plan44/p44ayabd/ayab_firmware/serial-protocol-docs/Communication Specification — AYABInterface 0.0.9 (AYAB serial protocol v4).pdf

Docs (http://ayabinterface.readthedocs.io/en/latest/index.html) » Communica-on Specifica-on

# Communication Specification

This document specifies the communica-on between the host and a controller with the AYAB firmware. (https://github.com/AllYarnsAreBeautiful/ayab-firmware)

## Serial Communication

115200 baud

Line Ending: | \n\r | (10 13) Each message ends with a Line Ending.

## Sequence Chart

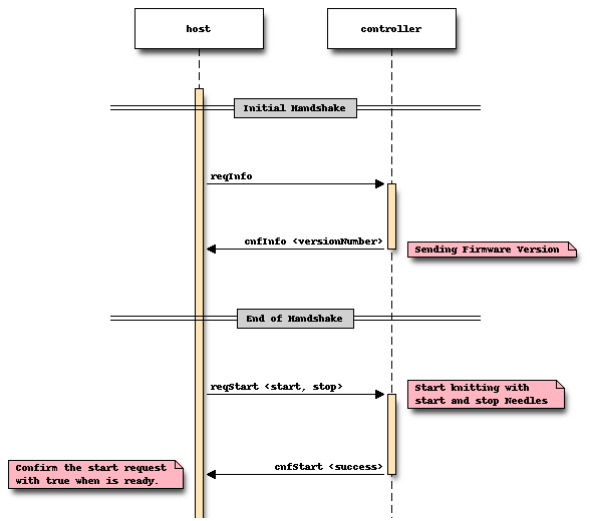
[picture p6: figure]

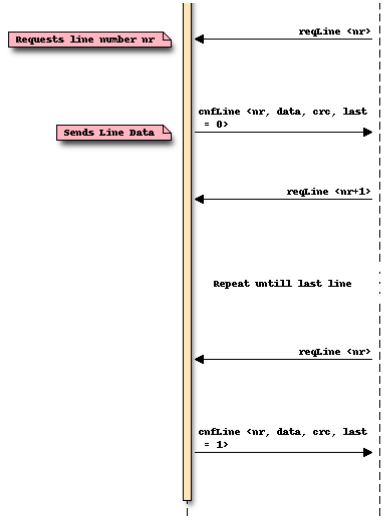
[picture p7: figure]

The host waits for a indState(true) message before reques-ng to start the kniLng. On startup, the Arduino con-nuously checks for the ini-aliza-on of the machine (carriage passed leQ hall sensor). When this happens, it sends an indState(true) to tell the host that the machine is ready to knit. AQer receiving this message, the host sends a reqStart message, which is immediately confirmed with a cnfStart message. When reqStart was successful, the Arduino begins to poll the host for line data with reqLine, the host answers with cnfLine. This reqLine/cnfLine happens each -me the carriage moves passed the borders given by the Start/StopNeedle parameters in reqStart. When the host does not have any more lines to send, it marks the last line with the lastLine flag in its last cnfLine message.

To see an example implementa-on, see the
states states ofof the the communication communication module module (http://ayabinterface.readthedocs.io/en/latest/reference/AYABInterface/communication/states.html) .

## Message Identifier Format

Messages start with a byte that iden-fies their type. This byte is called “id” or “message id” in the following document. This table lists all the bits of this byte and assigns their purpose:

Bit | Value | Name | Descrip8on and Values
7 | 128 | message source | 0 = the message is from the host 1 = the message is from the controller
6 | 64 | message type | 0 = the message is a request 1 = the message is a confirma-on of a request
5 | 32 | reserved | must be zero
4 | 16
3 | 8 | message iden-fier | These are the values that iden-fy the message. ! See also Message defini-ons (API v4)
2 | 4
1 | 2
0 | 1

## Message definitions (API v4)

The length is the total length with id and parameters. Note that the two characters
\r\n | following the message are not included in the length.
source | name | id | length | parameters
host | reqStart | 0x01 | 3

0xaa 0xbb

aa | = leQ end needle (Range: 0..198)
bb | = right end needle (Range: 1..199)

Start and

hardware | cnfStart | 0xC1 | 2

0x0a

a = success (0 = false, 1 = true)

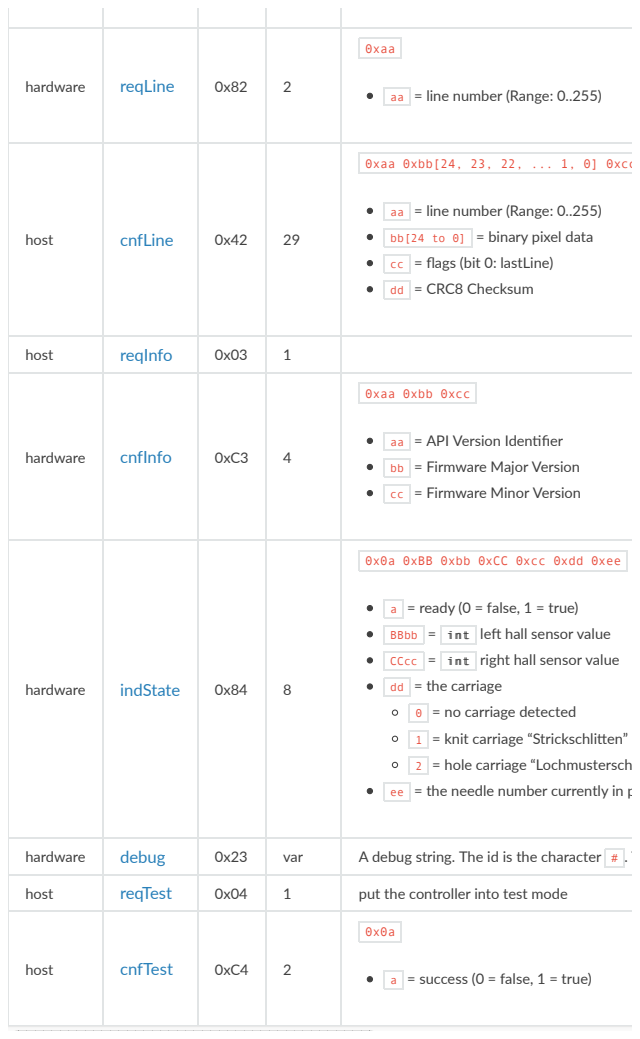
[picture p8: page 4]
hardware; reqLine; 0xaa; = line number (Range: 0..255); host; cnfLine; 0xaa 0xbb[24, 23, 22, ... 1, 0] 0xcc; = binary pixel data; = flags (bit 0: lastLine); = CRC8 Checksum; reqInfo; cnfInfo; 0xaa 0xbb 0xcc; = API Version Iden-fier; = Firmware Major Version; = Firmware Minor Version; indState; 0x0a 0xBB 0xbb 0xCC 0xcc 0xdd 0xee; = ready (0 = false, 1 = true); BBbb; int int; leQ hall sensor value; CCcc; right hall sensor value; = the carriage; = no carriage detected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

The | reqStart reqStart | Message

The host starts the kniLng process.

Python: StartRequest StartRequest (http://ayabinterface.readthedocs.io/en/latest/reference/AYABInterface/communication/host_messages.html)
Arduino: h_reqStart (https://github.com/AllYarnsAreBeautiful/ayab-firmware/blob/c236597c6fdc6d320f9f2db2ebeb17d64c438b64/ayab.ino)
table: reqStart
requests answer: The cnfStart Message direc-on: host → controller
The | cnfStart cnfStart | Message

The controller indicates the success of The reqStart Message.

Python: StartConfirmation StartConfirmation (http://ayabinterface.readthedocs.io/en/latest/reference/AYABInterface/communication/hardware_messages.html)
Arduino: h_reqStart (https://github.com/AllYarnsAreBeautiful/ayab-firmware/blob/c236597c6fdc6d320f9f2db2ebeb17d64c438b64/ayab.ino)
table: reqStart
answers: The reqStart Message direc-on: controller → host
The | reqLine reqLine | Message

The controller requests a new line from the host.

More than 256 lines are supported. There are three possibili-es for the next line based on the last line:

1. the new line is greater than the last line
2. the new line is lower than the last line
3. the new line is the last line

We choose the line closest to the last line. This is trivial for (3). In case two lines are equally distant from the last line, we choose the smaller line.

This is computed by the func-on | AYABInterface.utils.next_line() AYABInterface.utils.next_line() (http://ayabinterface.readthedocs.io/en/latest/reference/AYABInterface/utils.html) | which is
tested and can be seen as a reference implementa-on for other languages.

Python: LineRequest LineRequest (http://ayabinterface.readthedocs.io/en/latest/reference/AYABInterface/communication/hardware_messages.html)
Arduino: Kniger::reqLine (https://github.com/AllYarnsAreBeautiful/ayab-firmware/blob/c236597c6fdc6d320f9f2db2ebeb17d64c438b64/knitter.cpp)

table: reqLine
requests answer: The cnfLine Message direc-on: controller → host
The | cnfLine cnfLine | Message

The host answers The reqLine Message with a line configura-on.

This table shows the message content without the first byte that iden-fies the message:

Byte | Name | Descrip8on
0 | line number | These are the lowest 8 bit of the line. They must match the line number in

1

needle posi-ons

Each bit of the bytes represents a needle posi-on.

0 = “B”
1 = “D”

For the exact mapping of bits to needles see the table below

2

24

25

26 | flags
Bits: | 0000000L
L | - “LastLine” (0 = false, 1 = true)
27 | crc8 checksum | This checksum is computed from bytes 0 to 26, including byte 26. The controller may use this checksum to check the result and if the checksum does not match, it can send

In the following table, you can see the mapping of bytes to needles.

! Note

The Needles are counted from the leQmost needle on the machine.
The Needle count starts with | 0 | .
The Byte numbering is taken from the table above.
The Bit numbering is consistent with Message Iden-fier Format. The highest bit has the number 7 and the lowest bit has number 0.
Byte | 1 | 2

Bit | 0 | 1 | 2 | 3 | 4 | 5 | 6 | 7 | 0 | 1 | 2 | 3 | 4
Needle | 0 | 1 | 2 | 3 | 4 | 5 | 6 | 7 | 8 | 9 | ...
Python: | LineConfirmation LineConfirmation (http://ayabinterface.readthedocs.io/en/latest/reference/AYABInterface/communication/host_messages.html)
Arduino: h_cnfLine (https://github.com/AllYarnsAreBeautiful/ayab-firmware/blob/c236597c6fdc6d320f9f2db2ebeb17d64c438b64/ayab.ino)
table: cnfLine
answers: The reqLine Message direc-on: host → controller
The | reqInfo reqInfo | Message

The host ini-alizes the handshake.

Python: InformationRequest InformationRequest (http://ayabinterface.readthedocs.io/en/latest/reference/AYABInterface/communication/host_messages.html)
Arduino: h_reqInfo (https://github.com/AllYarnsAreBeautiful/ayab-firmware/blob/c236597c6fdc6d320f9f2db2ebeb17d64c438b64/ayab.ino)
table: reqInfo
requests answer: The reqInfo Message direc-on: host → controller
The | cnfInfo cnfInfo | Message

The controller answers The reqInfo Message with the API version.

Python: InformationConfirmation InformationConfirmation (http://ayabinterface.readthedocs.io/en/latest/reference/AYABInterface/communication/hardware_messages.html)
Arduino: h_reqInfo (https://github.com/AllYarnsAreBeautiful/ayab-firmware/blob/c236597c6fdc6d320f9f2db2ebeb17d64c438b64/ayab.ino)
table: cnfInfo
answers: The reqInfo Message direc-on: controller → host
The | indState indState | Message
This is sent when the controller indicates its state. When | ready | it is
1 | , then this is the first state indica-on. The machine is now ready to knit
0 | , the controller is in test mode. This message is sent periodically. The reqTest
Message switches this on.
Python: StateIndication StateIndication (http://ayabinterface.readthedocs.io/en/latest/reference/AYABInterface/communication/hardware_messages.html)
Arduino: Kniger::indState (https://github.com/AllYarnsAreBeautiful/ayab-firmware/blob/c236597c6fdc6d320f9f2db2ebeb17d64c438b64/knitter.cpp)
table: indState direc-on: controller → host
The | debug | Message
This message ends with a | \r\n | like evey message. It contains debug informa-on
from the controller.

Python: Debug Debug (http://ayabinterface.readthedocs.io/en/latest/reference/AYABInterface/communication/hardware_messages.html)
Arduino: DEBUG_PRINT (https://github.com/AllYarnsAreBeautiful/ayab-firmware/blob/c236597c6fdc6d320f9f2db2ebeb17d64c438b64/debug.h)
table: debug
direc-on: controller → host
The | reqTest reqTest | Message

This message puts the controller in a test mode instead of a kniLng mode.

Python: TestRequest TestRequest (http://ayabinterface.readthedocs.io/en/latest/reference/AYABInterface/communication/host_messages.html)
Arduino: h_reqTest (https://github.com/AllYarnsAreBeautiful/ayab-firmware/blob/c236597c6fdc6d320f9f2db2ebeb17d64c438b64/ayab.ino)
table: reqTest
requests answer: The cnfTest Message direc-on: host → controller
The | cnfTest cnfTest | Message

This messsage confirms whether the controller is in the test mode. If success is indicated, the controller sends The indState Message messages periodically, containing the sensor and posi-on values.

Python: TestConfirmation TestConfirmation (http://ayabinterface.readthedocs.io/en/latest/reference/AYABInterface/communication/hardware_messages.html)
Arduino: h_reqTest (https://github.com/AllYarnsAreBeautiful/ayab-firmware/blob/c236597c6fdc6d320f9f2db2ebeb17d64c438b64/ayab.ino)
table: cnfTest
answers: The reqTest Message direc-on: controller → host

## References

! See also

the original specifica-on (https://bitbucket.org/chris007de/ayab-apparat/wiki/english/Software/SerialCommunication)
the | hardware hardware messages messages module module (http://ayabinterface.readthedocs.io/en/latest/reference/AYABInterface/communication/hardware_messages.html) | for messages sent by the hardware

the | host host messages messages module module (http://ayabinterface.readthedocs.io/en/latest/reference/AYABInterface/communication/host_messages.html) | for messages sent by the host
a discussion about the specifica-on (https://github.com/AllYarnsAreBeautiful/ayab-desktop/issues/17)
