plan44/p44ayabd/mounting-plate/p44ayab_mount_v1_rpi_b.dxf

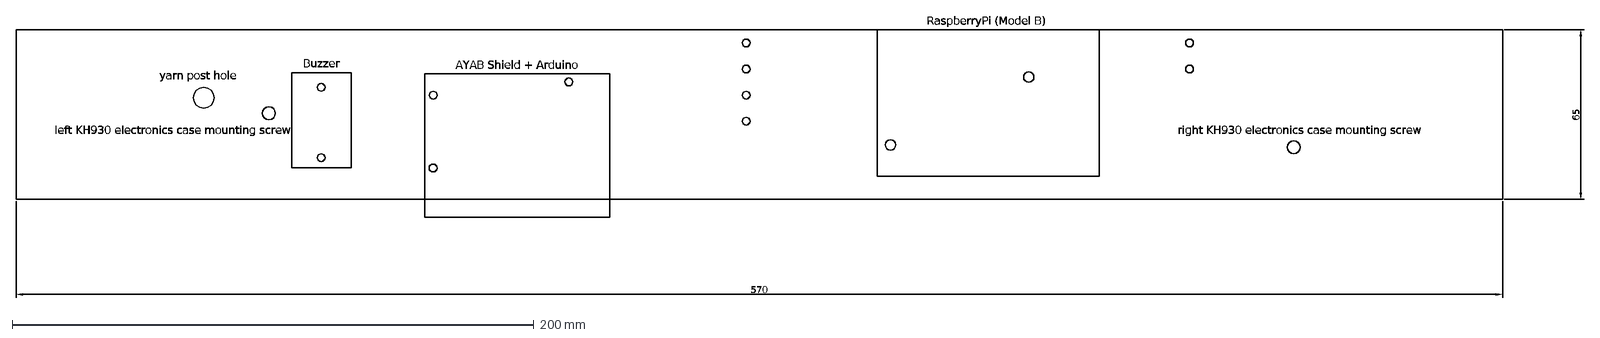
[picture p9: CAD file, 2015-12-30]
mounting-plate/p44ayab_mount_v1_rpi_b.dxf
Buzzer
AYAB Shield + Arduino
RaspberryPi (Model B)
right KH930 electronics case mounting screw
left KH930 electronics case mounting screw
yarn post hole
65
570
