plan44/p44ayabd/mounting-plate/p44ayab_mount_v1_rpi_b.pdf

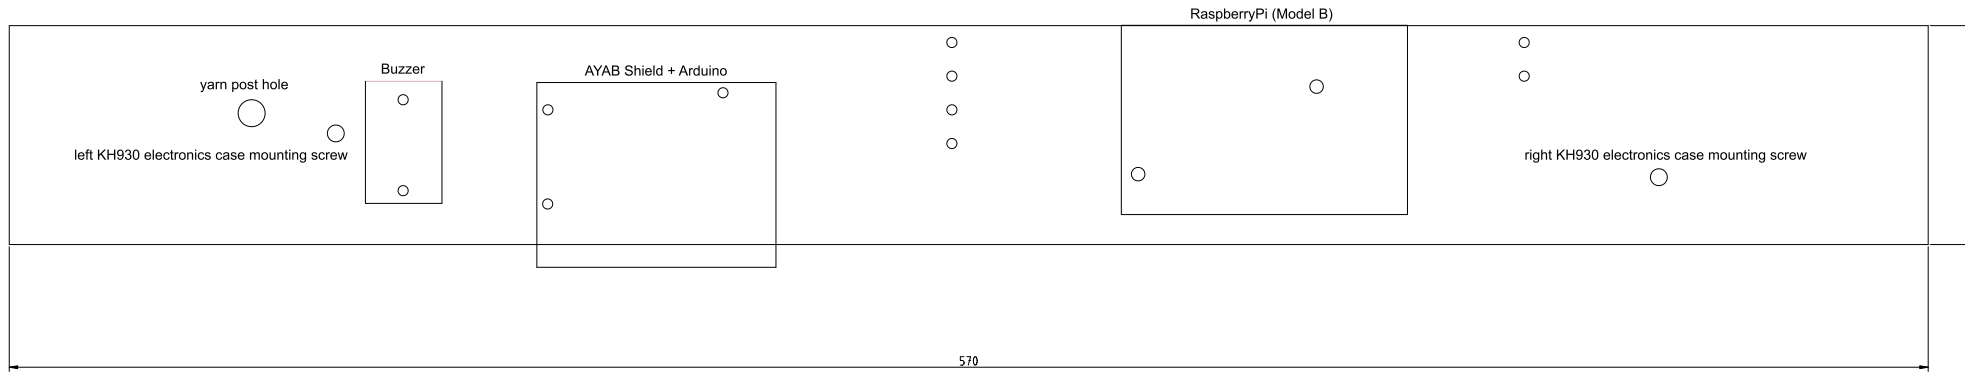
[picture p10: page 1]
