plan44/p44ayabd/mounting-plate/p44ayab_mount_v2_rpi_bplus.pdf

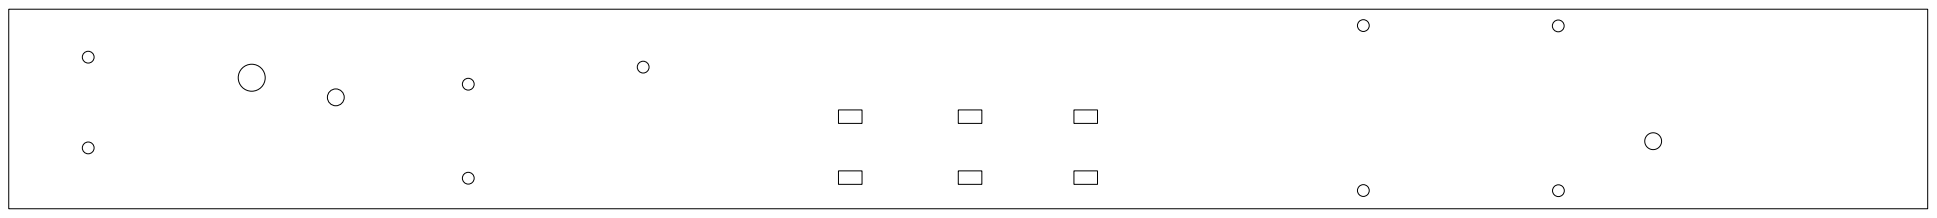
[picture p11: page 1]
