plan44/p44ayabd/(commit log)

2015-03-27 First knitting test version, hard wired image and serial port name
2015-05-04 Position cursor to image boundary implemented, restart with closing and re-opening communication port implemented (resets AYAB Arduino)
2015-05-05 Added Arduino reset via DTR
2015-05-09 P44utils: clearCallbacks() method trough entire SocketComm class hierarchy, plus clearHandlersAtClose flag to call it when connection closes. This is required to break retain cycles when handlers hav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
2015-12-28 Web-UI: Added Restart button to force-restart communication with AYAB
2015-12-30 Added DXF and PDF for mount plate (not perfect, but works)
    [p44ayab_mount.dxf]
2017-05-21 Added ayab arduino firmware snapshot from 2015, as newer versions seem to have different API
2017-10-20 configure.ac - WIP to make it build on LEDE 17.01
2017-11-05 mounting plate: new v2 version, for RPi B+, more room for USB cable
    [p44ayab_mount_v1_rpi_b.dxf]
2017-11-07 p44utils: removed outdated sources from main project - using current p44utils as submodule instead.
    Adapted main sources to p44utils API changes
2017-11-19 Added display of current image row, yarn color number and phase.
2017-11-20 Added cursor-to-zero button
